serverclaude123-cmyk/scada-mojokerto/README.md

# SCADA 2 VSD ABB – Mojokerto

Target: ABB ACS550 (untuk tes dipakai ACS310). PLC-nya Schneider M221, tapi drive-nya ABB.

```
VSD1 ─┐  Modbus RTU (RS485)              LAN 192.168.1.0/24
VSD2 ─┴──────────────── ESP32-ETH ───────────┐
         baca freq/arus                      │
         + TULIS setpoint (REFERENCE 1)      │
                                             │
PLC M221 ────────────────────────────────────┤   ON/OFF hardwired ke DI VSD
                                             │
PC ini ──────────────────────────────────────┘
  ├─ broker MQTT   ◄── ESP32 publish, FUXA subscribe
  └─ FUXA HMI      ──► Modbus TCP ke M221 (tombol START/STOP)
        ▲
        └── PC remote / HP: subscribe ke broker yang sama
```

| Fungsi | Jalur |
|---|---|
| Monitoring freq out, setpoint, arus, run/fault/comm | VSD → ESP32 (Modbus RTU) → MQTT → **broker di PC ini** → FUXA / remote |
| **Setpoint frekuensi** | MQTT → ESP32 → Modbus RTU **REFERENCE 1 (40002)** → VSD |
| Perintah ON/OFF | FUXA → **Modbus TCP ke PLC M221** → output PLC → DI VSD (hardwired) |

Pembagian kewenangan yang penting: **ESP32 boleh mengatur kecepatan, tapi tidak boleh menjalankan atau
menghentikan motor.** Yang ditulisnya hanya REFERENCE 1 (`40002`), bukan Control Word (`40001`), dan ada
pagar `#error` di `config.h` yang mencegah salah arah. Start/stop sepenuhnya milik PLC M221 lewat kontak
hardwired, dengan interlock Local/Remote dan e-stop di sisi PLC.

Gambar lengkap (arsitektur, wiring RS485 dengan nomor terminal, jalur perintah PLC): **[`docs/arsitektur-wiring.html`](docs/arsitektur-wiring.html)** — buka di browser, bisa di-print A3.
Proyek FUXA siap import: **[`fuxa/`](fuxa/)**.

## IP plan (contoh, ubah sesuai LAN)
| Perangkat | IP |
|---|---|
| Router | 192.168.1.1 |
| PC ini — broker MQTT + FUXA | 192.168.1.10 |
| PLC M221 | 192.168.1.113 (terbaca di lapangan; rencana awal .20) |
| ESP32 | 192.168.1.11 (DHCP; `config.h` masih menyetel statis .50 — belum dipakai board) |

## 1. Firmware ESP32
Board: KhursLabs ESP32-S3 IoT Acquisition RS485-Ethernet (W5500: CS 5, MOSI 11, SCK 12, MISO 13, RST 21, INT 47; RS485 UART1 **TX 15 / RX 16**, auto-direction). Pin W5500 dan RS485 keduanya sesuai dokumentasi KhursLabs: W5500 dari silkscreen board, RS485 dari contoh resmi `Test_sht20_RS485.ino`. Folder: `firmware/` (PlatformIO, platform pioarduino / arduino-esp32 3.x). Ubah dulu:
1. `include/secrets.h` → host/user/password broker MQTT.
2. `include/config.h` → IP, baud (`MB_BAUD` harus sama dengan par 5303 drive), slave ID VSD, alamat register.
   Terminal sekrup "SERIAL 1" (17/18) **bukan** jalur RS485 — itu breakout UART TTL terpisah.

```bash
cd firmware
pio run -t upload
pio device monitor
```

### VSD ABB ACS550 – Modbus RTU on-board (EFB)
Tidak perlu modul fieldbus tambahan. Wiring di terminal X1:
```
ESP32 modul RS485        ACS550 #1 (X1)      ACS550 #2 (X1)
 A (-) ───────────────── 30 (A, negatif) ─── 30 (A)
 B (+) ───────────────── 29 (B, positif) ─── 29 (B)   (label modul bisa terbalik; tukar bila tak komunikasi)
 GND  ────────────────── 31 (AGND) ───────── 31 (AGND)
 shield ──────────────── 28 / 32 (SCR) — ground shield di satu ujung saja
```
- Kabel twisted pair berselubung. Terminasi 120 Ω di ujung bus (ACS550 punya switch terminasi di board kontrol – cek manual; satu lagi di modul RS485).
- Parameter di tiap drive:

| Param | Nilai |
|---|---|
| 9802 COMM PROT SEL | 1 (STD MODBUS) |
| 5302 EFB STATION ID | **1** (VSD1), **2** (VSD2) |
| 5303 EFB BAUD RATE | **19.2 kbps** — dikonfirmasi di lapangan; harus sama dengan `MB_BAUD` di `config.h` |
| 5304 EFB PARITY | 0 = 8 NONE 1 (default pabrik 1 = 8N2, harus diubah) |
| 5305 EFB CTRL PROFILE | **0** = ABB DRV LIM (profil ABB Drives; 1 = DCU, jangan dipakai) |
| 1001 EXT1 COMMANDS | **9** — terbaca di drive terpasang (10 Nov 2026). Sumber **start/stop**, dari digital input yaitu PLC. **9 bukan COMM**: manual ACS550 menyebut COMM = **10** (lihat deskripsi fault 1007). Jangan diubah ke 10, start/stop memang bukan lewat Modbus. |
| 1103 REF1 SELECT | **8 = COMM** — sumber **referensi frekuensi**, dari Modbus (ESP32). Wajib 8 supaya tulis setpoint ke 40002 dipakai drive. |
| 1105 REF1 MAX | **50,0 Hz** — harus sama dengan `REF1_MAX_HZ` di `config.h`, lihat bagian setpoint. |

- Setelah ganti 9802, power-cycle / tunggu EFB restart. Cek par 5306–5309 (EFB OK/ERR frames) naik saat polling jalan.
- **1001 dan 1103 mengatur dua hal yang BERBEDA dan berdiri sendiri.** 1001 = sumber start/stop
  (di sini 9 = digital input dari PLC); 1103 = sumber referensi frekuensi (di sini 8 = COMM lewat
  Modbus). Jadi wajar start/stop lewat PLC sementara setpoint lewat ESP32 -- keduanya tidak saling
  meniadakan. Dulu bagian ini tertulis "Modbus hanya dibaca"; itu sudah tidak berlaku sejak tulis
  setpoint diaktifkan.
- Kalau benar 9 = `DI1F,2R` (sumber sekunder, **belum dikonfirmasi dari manual ABB**), maka
  **DI2 berarti perintah jalan MUNDUR**. Pastikan tidak ada kabel PLC yang tersambung ke DI2
  tanpa sengaja sebelum motor disambung.

Register yang dibaca (`config.h`). Alamat PDU = nomor register − 40001:

| Isi | Register | Alamat PDU | Skala |
|---|---|---|---|
| Status Word | `40004` | 3 | bit |
| par 0103 OUTPUT FREQ | `40103` | 102 | 0,1 Hz |
| par 0104 CURRENT | `40104` | 103 | 0,1 A |
| par 0107 DC BUS VOLTAGE | `40107` | 106 | 1 V |
| par 0109 OUTPUT VOLTAGE | `40109` | 108 | 1 V |
| par 0111 EXT REF 1 | `40111` | 110 | 0,1 Hz |

Bit status: `RDY_REF` = run, `TRIPPED` = fault.

Par 0103–0111 diambil dalam **satu** FC03 (alamat 102, 9 register) supaya lalu lintas RS485 turun dari 6 transaksi jadi 2 per VSD per siklus. Kalau drive menolak rentang itu (exception 02), firmware otomatis kembali membaca satu-satu dan mencatatnya di serial monitor — matikan permanen dengan `MB_BLOCK_READ 0`.

### Tulis setpoint frekuensi (AKTIF)
`ALLOW_SETPOINT_WRITE 1` di `config.h`. ESP32 menulis **REFERENCE 1** (`40002`, alamat PDU 1, FC06) dari topik MQTT `scada/mojokerto/vsd1/cmd/freq_set` (dan `vsd2/...`). Isi `0` kalau mau sementara mengembalikan firmware ke murni read-only.

- Yang ditulis hanya nilai referensi, **bukan Control Word** (`40001`) — jadi ESP32 tetap tidak bisa start/stop motor. Ada pagar `#error` di `config.h` kalau `REG_REF1` sampai diisi 0.
- Prasyarat di drive: par **1103 REF1 SELECT = 8 (COMM)** dan panel pada mode **REM**. Tanpa itu nilainya ditulis tapi diabaikan drive.
- Skala: `20000` = par **1105 REF1 MAX**. **`REF1_MAX_HZ` di `config.h` harus sama dengan
  nilai par 1105 di drive.** Kalau berbeda, kecepatan bergeser diam-diam tanpa error apa pun --
  pernah terjadi di sini: 1105 masih 25,0 Hz sementara config 50,0, sehingga permintaan 25 Hz
  diterima drive sebagai 12,5 Hz dengan `cmd_ok` tetap 1. Isi `REF1_MAX_HZ` sesuai nilai 1105 di drive (resolusi 0,1 Hz: 500 = 50,0 Hz).
- Nilai dari MQTT di-clamp ke `REF_CLAMP_MIN_HZ`…`REF_CLAMP_MAX_HZ`.
- Publish perintah **tanpa retained** — perintah retained akan dipakai ulang tiap kali ESP32 reconnect.
- Echo: `vsd1/freq_cmd` (Hz yang benar-benar dikirim) dan `vsd1/cmd_ok` (1 = drive mengakui tulisan).

### Topik MQTT (payload angka/teks biasa, retained)
Basis: `scada/mojokerto`

| Topik | Isi |
|---|---|
| `gw/status` | `online` / `offline` (LWT) |
| `gw/ip`, `gw/uptime` | IP ESP32, uptime detik |
| `vsd1/freq_out`, `vsd2/freq_out` | frekuensi output (Hz) |
| `vsd1/freq_set`, `vsd2/freq_set` | setpoint frekuensi (Hz) |
| `vsd1/current`, `vsd2/current` | arus motor (A) |
| `vsd1/volt_dc`, `vsd2/volt_dc` | tegangan DC bus (V) |
| `vsd1/volt_out`, `vsd2/volt_out` | tegangan output (V) |
| `vsd1/running`, `vsd1/fault`, `vsd1/ready` (idem `vsd2/…`) | 0 / 1 |
| `vsd1/comm_ok`, `vsd2/comm_ok` | 1 = ESP32 berhasil baca VSD |
| `vsd1/status_word`, `vsd1/err_count` (idem `vsd2/…`) | diagnosa |
| `vsd1/cmd/freq_set`, `vsd2/cmd/freq_set` | **masuk** — setpoint Hz, hanya bila `ALLOW_SETPOINT_WRITE 1` |
| `vsd1/freq_cmd`, `vsd1/cmd_ok` (idem `vsd2/…`) | echo setpoint yang dikirim + hasilnya |

Publish tiap 2 detik dan langsung saat status run/fault/comm berubah.

### Hal yang HARUS dicek di hardware
- **Alamat register** sudah dicocokkan ke manual ACS550/ACS310 dan sebagian dibuktikan dengan Modbus Poll di ACS310 (Status Word terbaca). Tetap bandingkan nilai di serial monitor dengan panel drive (par 0103/0104/0111); kalau bergeser satu parameter, ubah offset ±1 di `config.h` (masalah 0-based vs 1-based).
- Dekode status memakai profil ABB Drives (par 5305 = 0). Kalau profil DCU (5305 = 1), bit-nya berbeda.
- **Rentang blok baca** 102..110: kalau drive menolak (exception 02), serial monitor mencetak `[MB] … ditolak, pakai baca satu-satu` dan firmware lanjut jalan — bukan kegagalan fatal.
- `freq_set` = par 0111 EXT REF 1. Kalau setpoint di sistem Anda lewat EXT REF 2 (%) atau panel, sesuaikan.
- TLS: broker lokal dipakai tanpa TLS (`MQTT_USE_TLS 0`, port 1883) — lalu lintasnya tidak keluar LAN. Kalau broker nanti diberi TLS, set `MQTT_USE_TLS 1` dan port 8883.

## 2. PLC M221 (SoMachine Basic)
1. Ethernet: **IP 192.168.1.113** (terbaca di lapangan; rencana awal .20), gateway 192.168.1.1.
   Modbus TCP server aktif di port 502, menjawab unit id berapa pun.
2. Program:

| Alamat | Nama | Arah | Keterangan |
|---|---|---|---|
| `%M0` | START_VSD1 | FUXA→PLC | **pulse**, 1 = perintah start |
| `%M1` | STOP_VSD1 | FUXA→PLC | **pulse**, 1 = perintah stop |
| `%M2` | START_VSD2 | FUXA→PLC | **pulse** |
| `%M3` | STOP_VSD2 | FUXA→PLC | **pulse** |
| `%MW10` | HEARTBEAT | FUXA→PLC | ditulis FUXA tiap 1 s |
| `%I0.0` | SEL_REMOTE | input | selector Local/Remote |
| `%I0.1` | ESTOP_OK | input | NC e-stop |
| `%I0.2` / `%I0.3` | VSD1/VSD2 fault relay | input | dari relay VSD (opsional) |
| `%Q0.0` | RUN_VSD1 | output | ke DI forward VSD1 |
| `%Q0.1` | RUN_VSD2 | output | ke DI forward VSD2 |

Perintah dari FUXA bersifat **pulse**: START dan STOP adalah bit terpisah. Tombol di FUXA
menulis `1` saat ditekan (mousedown) dan `0` saat dilepas (mouseup), jadi bit-nya naik
selama tombol ditahan lalu turun sendiri.

PLC memakai SET/RESET langsung ke output. Berikut program lengkapnya dalam **Instruction List**
(SoMachine Basic / EcoStruxure Machine Expert - Basic). Empat baris pertama adalah yang sudah ada
di `m221 plc.smbp`; sisanya yang perlu ditambahkan.

```
(* ============ 1. SET/RESET output. STOP ditaruh SESUDAH START ============ *)
(* Urutan ini penting: kalau START dan STOP sama-sama aktif dalam satu scan, *)
(* RESET yang dieksekusi belakangan akan menang -- itu yang kita mau.        *)
LD    %M0
S     %Q0.0
LD    %M1
R     %Q0.0
LD    %M2
S     %Q0.1
LD    %M3
R     %Q0.1

(* ============ 2. Bersihkan bit perintah -- INI YANG BELUM ADA ============ *)
(* Tanpa ini, satu bit yang tertinggal 1 akan di-SET/RESET ulang tiap scan   *)
(* dan tombol lawannya tidak akan pernah mempan.                            *)
LD    %M0
R     %M0
LD    %M1
R     %M1
LD    %M2
R     %M2
LD    %M3
R     %M3

(* ============ 3. Interlock: Local/Remote dan E-stop ============ *)
(* %I0.0 = 1 saat selector di REMOTE; %I0.1 = 1 saat e-stop SEHAT (kontak NC) *)
LDN   %I0.0
ORN   %I0.1
R     %Q0.0
LDN   %I0.0
ORN   %I0.1
R     %Q0.1

(* ============ 4. Interlock fault drive (kalau relay fault dikabel) ======= *)
LD    %I0.2
R     %Q0.0
LD    %I0.3
R     %Q0.1

(* ============ 5. Salin status output RUN untuk FUXA ============ *)
(* FUXA membaca %M4/%M5 sebagai coil (tag plc_run_vsd1/2, address 5/6).    *)
(* Taruh PALING BAWAH supaya yang tersalin adalah hasil akhir scan.         *)
LD    %Q0.0
ST    %M4
LD    %Q0.1
ST    %M5
```

Blok 3 dan 4 harus berada **di bawah** blok 1, supaya interlock selalu menang atas perintah START.

### Cara menambahkannya di EcoStruxure Machine Expert - Basic
Proyek `m221 plc.smbp` saat ini berisi **1 POU dengan 4 rung** (8 instruksi di atas).
Yang perlu ditambahkan adalah rung ke-5 dan seterusnya, **di bawah rung 4**.

Kalau lebih nyaman menggambar daripada mengetik IL, tiap rung baru isinya sederhana —
satu kontak dan satu coil Reset:

| Rung | Kontak | Coil |
|---|---|---|
| 5 | `%M0` normally open | **Reset** `%M0` |
| 6 | `%M1` normally open | **Reset** `%M1` |
| 7 | `%M2` normally open | **Reset** `%M2` |
| 8 | `%M3` normally open | **Reset** `%M3` |
| 9 | `%I0.0` normally **closed**, diparalel dengan `%I0.1` normally **closed** | **Reset** `%Q0.0` |
| 10 | sama seperti rung 9 | **Reset** `%Q0.1` |
| 11 | `%I0.2` normally open | **Reset** `%Q0.0` |
| 12 | `%I0.3` normally open | **Reset** `%Q0.1` |
| 13 | `%Q0.0` normally open | coil biasa `%M4` |
| 14 | `%Q0.1` normally open | coil biasa `%M5` |

Rung 5–8 membersihkan bit perintah. Rung 9–12 interlock, dan harus berada di bawah rung 1–4
supaya selalu menang atas perintah START.

Catatan soal rung 9 dan 10: kontaknya **normally closed** dan **diparalel**, karena artinya
"selector TIDAK di Remote **atau** e-stop TIDAK sehat". `%I0.0` = 1 saat selector di REMOTE,
`%I0.1` = 1 saat e-stop sehat (kontak NC tertutup).

Rung 11 dan 12 hanya dipasang kalau relay fault drive memang dikabel ke input itu.

### Membersihkan bit yang sudah terlanjur nyangkut
Sebelum program baru di-download, cek dulu kondisi sekarang lewat animation table
SoMachine Basic: `%M0`–`%M3` harus semuanya 0. Per 1 Nov 2026 pembacaan Modbus menunjukkan
`%M1` dan `%M2` masih **1** — sisa percobaan tombol sebelum blok 2 ada. Paksa keduanya ke 0,
atau cukup download program baru lalu power-cycle PLC.

### Watchdog komunikasi (nanti, jangan dulu)
Rencananya: FUXA menaikkan `%MW10` tiap 1 detik; kalau nilainya diam 5 detik, PLC me-reset
`%Q0.0`/`%Q0.1` supaya motor berhenti saat PC atau jaringan putus.

Implementasinya butuh timer `%TM0` (TON, 5 s) dan satu word salinan untuk mendeteksi perubahan:
bandingkan `%MW10` dengan `%MW11`, reset timer kalau berbeda, lalu simpan `%MW11 := %MW10`.
**Buat ini di editor ladder, bukan disalin sebagai IL** — sintaks blok timer berbeda antar versi
SoMachine Basic dan mudah salah kalau ditulis buta.

> **Jangan aktifkan watchdog sebelum heartbeat-nya jalan.** FUXA tidak menulis `%MW10` dengan
> sendirinya — tag-nya sudah ada di proyek, tapi nilainya harus dinaikkan oleh *script* FUXA
> (Scripts → jadwal 1 detik, `$setTag('plc_heartbeat', ($getTag('plc_heartbeat') + 1) % 32767)`).
> Kalau watchdog dinyalakan di PLC tapi script-nya belum ada, motor tidak akan pernah bisa run.

Mode Local (selector) tetap mengutamakan operator di panel.

> **Jangan aktifkan watchdog sebelum heartbeat-nya jalan.** FUXA tidak menulis `%MW10` dengan
> sendirinya — tag-nya ada, tapi nilainya harus dinaikkan oleh *script* FUXA (Scripts → jadwal 1 s,
> `$setTag('plc_heartbeat', ($getTag('plc_heartbeat') + 1) % 32767)`). Kalau watchdog dinyalakan di PLC
> tapi script-nya belum ada, motor tidak akan pernah bisa run.

## 3. Broker MQTT (di PC ini)

Broker adalah simpul tengah arsitektur ini: ESP32 publish ke sini, FUXA dan klien remote subscribe dari sini.
**Belum terpasang** — per 1 Nov 2026 tidak ada yang listen di 1883/8883 di PC ini dan Mosquitto belum ada.

Pilihan paling sederhana: **Eclipse Mosquitto**. Yang perlu ada di `mosquitto.conf`:

```
listener 1883 0.0.0.0
allow_anonymous false
password_file C:\Program Files\mosquitto\passwd
```

- `listener 1883 0.0.0.0` — tanpa ini Mosquitto hanya mendengar di localhost dan **ESP32 tidak akan bisa masuk**.
- Buat user dengan `mosquitto_passwd -c passwd esp32`, lalu isi user/password yang sama di `firmware/include/secrets.h`.
- Buka port 1883 di Windows Firewall untuk jaringan privat.
- `MQTT_HOST` di `secrets.h` diisi **IP LAN PC ini** (`192.168.1.10`), bukan `localhost`.

PC ini harus tetap menyala: kalau broker mati, FUXA dan semua klien remote kehilangan data,
walaupun ESP32 dan PLC tetap jalan sendiri.

### Akses dari luar (PC remote / HP)
Selama semua klien ada di LAN yang sama, cukup arahkan ke `192.168.1.10:1883`.

Untuk akses dari luar jaringan, **jangan port-forward 1883 apa adanya ke internet**. Port MQTT polos
tanpa TLS berarti user dan password lewat sebagai teks biasa, dan broker yang terbuka akan discan
dalam hitungan jam — padahal topik `cmd/freq_set` di broker ini bisa mengubah kecepatan motor.
Dua jalan yang aman: VPN (WireGuard/Tailscale) sehingga HP seolah berada di LAN, atau aktifkan
TLS di Mosquitto (port 8883, sertifikat) lalu set `MQTT_USE_TLS 1` di `config.h`.

## 4. FUXA (PC lokal)
**Device 1 – MQTT (monitoring)**
- Connections → Add → *MQTT client*; URL `mqtts://<host-broker>:8883`, isi user/password.
- Tambahkan tag dengan tipe *Subscription*, topik penuh, mis. `scada/mojokerto/vsd1/freq_out`, untuk semua topik di tabel di atas.

**Device 2 – Modbus TCP (perintah)**
- Add → *Modbus TCP*; `192.168.1.20:502`, Slave ID 1 (atau 255 untuk M221).
- Tag Coil: `%M0`–`%M3` (START1, STOP1, START2, STOP2). Tag heartbeat: Holding Register `%MW10`.
  **Catatan alamat:** FUXA memakai alamat 1-based dan mengurangi 1 sebelum mengirim ke bus,
  jadi `%M0` diisi address **1**, `%M1` → **2**, `%M2` → **3**, `%M3` → **4**, `%MW10` → **11**.
- Tombol START/STOP memakai aksi *set value* = `1` ke coil masing-masing (pulse).
- Beri konfirmasi (dialog) pada tombol START/STOP di FUXA.
- Semua tag di atas sudah jadi di `fuxa/scada-mojokerto.fuxap` — tinggal import, lihat `fuxa/README.md`.

**Layar**: 2 panel (VSD1/VSD2) berisi lampu RUN/FAULT/COMM, nilai Hz out, Hz set, Arus, tombol START/STOP, indikator `gw/status`. Alarm: `fault=1`, `comm_ok=0`, `gw/status=offline`.

Menu/nama field FUXA bisa sedikit berbeda antar versi.

## Status
Firmware **sudah dikompilasi bersih** (arduino-esp32 3.3.12 — RAM 9.7%, Flash 56.7%, tanpa warning),
tapi **belum pernah dijalankan di hardware**: W5500, RS485 TX15/RX16, MQTT, dan blok baca 102..110
semuanya masih belum terbukti.

Proyek FUXA sudah jadi dan sudah diuji import ke FUXA 1.3.5 — lihat `fuxa/README.md`.
Program PLC M221 belum dibuat; ladder contohnya ada di bagian 2 di atas.
