serverclaude123-cmyk/scada-mojokerto/fuxa/README.md

# Proyek FUXA – SCADA Mojokerto

`scada-mojokerto.fuxap` = file proyek FUXA siap import. Dibuat oleh `make_project.py`
(jalankan `python fuxa/make_project.py` kalau daftar tag berubah; jangan edit `.fuxap` manual).

## Isi

| Bagian | Jumlah | Keterangan |
|---|---|---|
| Device `MQTT Broker` | 31 tag | monitoring, subscribe ke `scada/mojokerto/#` |
| Device `PLC M221` | 5 tag | Modbus TCP, 4 bit perintah pulse + heartbeat |
| View `Overview` | 28 gauge | 2 panel VSD: lampu RUN/FAULT/COMM, 5 nilai, tombol START/STOP |
| Alarm | 4 | fault & comm-lost per VSD |

## Menjalankan FUXA
Tidak ada installer Windows di halaman rilis FUXA — distribusinya lewat npm atau Docker.
Butuh Node.js (diuji dengan **Node 22 LTS**; Node 26 dihindari karena modul native FUXA
belum tentu punya prebuild).

```bash
npm install -g @frangoteam/fuxa
fuxa
```

Lalu buka **http://localhost:1881**.

> Jalankan `fuxa` dari shell yang PATH-nya memuat `npm`. FUXA memanggil `npm` saat memasang
> plugin; kalau tidak ketemu, pemasangan plugin gagal dengan `'npm.cmd' is not recognized`.

## Plugin Modbus harus dipasang dulu
Paket npm FUXA **tidak** menyertakan driver Modbus. Tanpa itu, log hanya menulis
`try to create PLC M221 but plugin is missing!` dan device PLC diam saja.

Pasang lewat **Settings → Plugins → `modbus-serial`** (versi yang dipakai di sini: 8.0.19).
Driver MQTT sudah bawaan, tidak perlu plugin.

## Cara import
1. Buka FUXA → menu **☰ → Open/Save project** → **Load project** → pilih `scada-mojokerto.fuxap`.
2. **Edit kredensial broker** (tidak disimpan di Git): Connections → `MQTT Broker` →
   isi `GANTI-USER` / `GANTI-PASSWORD` sesuai user yang dibuat di Mosquitto.
   URL-nya sudah `mqtt://localhost:1883` karena broker ada di PC yang sama dengan FUXA.
   (ESP32 tidak boleh pakai `localhost` — di `secrets.h` isi IP LAN PC ini.)
3. Cek `PLC M221`: alamat `192.168.1.113:502`, Slave ID `1`. Kalau M221 tidak menjawab,
   coba Slave ID `255`.

## Pemetaan alamat Modbus ke PLC — PERHATIAN
FUXA memakai alamat **1-based** lalu mengurangi 1 sebelum mengirim ke bus
(`server/runtime/devices/modbus/index.js`: `parseInt(address) - 1`). Jadi:

| PLC M221 | Tag FUXA | Area Modbus | `memaddress` | `address` di FUXA |
|---|---|---|---|---|
| `%M0` START VSD1 | `plc_start_vsd1` | coil | `0` | **1** |
| `%M1` STOP VSD1 | `plc_stop_vsd1` | coil | `0` | **2** |
| `%M2` START VSD2 | `plc_start_vsd2` | coil | `0` | **3** |
| `%M3` STOP VSD2 | `plc_stop_vsd2` | coil | `0` | **4** |
| `%MW10` heartbeat | `plc_heartbeat` | holding register | `400000` | **11** |

Kalau tombol tampak menulis ke bit yang salah (geser satu), inilah tempat memeriksanya.

**`memaddress` harus 6 digit.** Driver Modbus FUXA membangun kunci area lewat `getMemoryAddress()`
yang mengembalikan `'000000'` untuk coil. Kalau tag diisi `'0'`, kunci tidak cocok dan tag gagal
dimuat dengan `'PLC M221' load error! TypeError: Cannot read properties of undefined (reading 'Items')`
— device tetap "created" jadi kesalahannya mudah terlewat. Pakai `000000` / `100000` / `300000` / `400000`.

## Tombol momentary (pulse 1 → 0)
Tiap tombol punya **dua** event: `mousedown` menulis `1`, `mouseup` menulis `0`.
Jadi bit perintah naik selama tombol ditahan lalu turun sendiri saat dilepas.

```json
"events": [
 {"type": "mousedown", "action": "onSetValue", "actparam": "1", "actoptions": {"variablesMapping": []}},
 {"type": "mouseup",   "action": "onSetValue", "actparam": "0", "actoptions": {"variablesMapping": []}}
]
```

**Nama event harus persis seperti itu.** FUXA 1.3.5 memakai nama pendek (`mousedown`, `onSetValue`).
Bentuk `shapes.event-mousedown` / `shapes.event-onsetvalue` yang ada di `hmi.ts` branch master
adalah format versi yang **belum dirilis** — dipakai di 1.3.5, dropdown Type/Action di editor
tampil kosong dan event-nya tidak jalan sama sekali. Acuan yang benar: konfigurasi satu tombol
lewat editor FUXA lalu baca `GET /api/project`.

Mode `buttonAction` (press/release dengan `minHoldTime`) juga hanya ada di master — tidak ada
di 1.3.5, jangan dipakai sampai versinya naik.

### PLC tetap harus membersihkan bit perintah
Lebar pulse = selama operator menahan tombol. Kalau browser, PC, atau jaringan mati di antara
mousedown dan mouseup, bitnya tertinggal `1`. Dengan pola SET/RESET di PLC, `%M0` yang terus `1`
akan me-SET ulang `%Q0.0` tiap scan dan **STOP tidak akan pernah bisa mematikan motor**.
Karena itu program PLC wajib punya `RESET %M0..%M3` setelah memprosesnya — lihat `../README.md`.

## Heartbeat `%MW10` belum otomatis
Tag `plc_heartbeat` sudah ada, tapi **tidak ada script yang menaikkannya** di proyek ini.
Kalau watchdog di PLC diaktifkan tanpa script ini, motor tidak akan pernah bisa run.
Buat di FUXA: Scripts → script baru, jadwal tiap 1 detik:

```js
$setTag('plc_heartbeat', ($getTag('plc_heartbeat') + 1) % 32767);
```

Nama fungsi script bisa berbeda antar versi FUXA — cek daftar fungsi di editor script.

## Status verifikasi
Sudah di-import ke **FUXA 1.3.5** (Node 22.23.4) dan diperiksa:

- Kedua device dimuat tanpa error (`'MQTT Broker' created/start`, `'PLC M221' created/start`).
- View ter-render: 2 panel, lampu RUN/FAULT/COMM, 5 nilai per VSD dengan placeholder `##.#`,
  tombol START/STOP berlabel, blok diagnosa.
- Alarm dan semua tag masuk.
- Di PC lapangan (1 Nov 2026) keduanya tersambung: `'MQTT Broker' start` ke
  `mqtt://localhost:1883` dan `'PLC M221' connected!` ke `192.168.1.113:502`.
  Nilai live masuk: `gw/status online`, `vsd2/comm_ok 1`, `vsd2/volt_dc 279`.
  `vsd1/comm_ok 0` dengan `err_count` terus naik itu wajar — VSD1 belum dipasang.
- Delapan `'PLC M221' _readMemory error!` di awal start adalah gejolak koneksi pertama
  (`ERR_STREAM_WRITE_AFTER_END` di `tcpport.js`), bukan tanda PLC bermasalah. Setelah
  `connected!` log bersih. Jangan buang waktu mengejarnya.

- Tombol momentary diuji dengan menekan 400 ms: FUXA memanggil `setValue` dua kali dan
  driver Modbus menghitung `val: 1` lalu `val: 0` untuk coil offset yang benar.

Yang **belum** diuji dan masih jadi tugas di lapangan:
- **Tulis coil ke M221 sungguhan.** Nilai live dari broker sudah terbukti, tapi menekan
  START/STOP ke PLC lapangan belum pernah dicoba. Perlu hati-hati: `%M1` dan `%M2` di PLC
  masih tersangkut ON, dan drive sekarang sudah di mode REMOTE.
- **Dialog konfirmasi START/STOP belum ada.** Tombol ini menjalankan motor lewat PLC.
  Tambahkan konfirmasi di editor FUXA (property tombol) **sebelum dipakai di lapangan**.
- Posisi/ukuran elemen: koordinat tetap 1200×800, rapikan di editor kalau perlu.

### Kotak isian setpoint
Tiap panel punya kotak isian yang terhubung ke tag publish `vsdN_cmd_freq_set`.
Ketik angka lalu tekan **Enter** untuk mengirim.

Strukturnya sama polanya dengan tombol: `<g id="HXI_...">` berisi `<rect>` dan
`<foreignObject>` dengan `<INPUT id="I-HXI_...">`. Tanpa INPUT ber-prefiks `I-` itu,
FUXA hanya menggambar kotak putih yang tidak bisa diketik.

Terbukti ujung ke ujung: isian di FUXA -> `vsd2/cmd/freq_set` -> ESP32 -> Modbus FC06
ke 40002 -> drive ACK, terlihat dari `vsd2/cmd_ok` yang berubah 0 menjadi 1.

Diuji ulang 1 Nov 2026 lewat UI sungguhan di browser: ketik `15` lalu Enter pada kotak VSD2,
broker langsung melaporkan `vsd2/freq_set 15.0`, `vsd2/freq_cmd 15.0`, `vsd2/cmd_ok 1`.
Angkanya 15.0 dan bukan 7.5 — itu bukti par 1105 (REF1 MAX) di drive benar-benar 50 Hz dan
cocok dengan `REF1_MAX_HZ` di firmware. Setelah itu dikembalikan ke 0.

### Penanda revisi di pojok kanan atas
Tiap view memuat teks kecil `rev xxxxxxxx` di sudut kanan atas. Itu hash dari isi proyek
(items, svgcontent, daftar tag, nama alarm) yang dihitung `make_project.py` sebelum stempelnya
sendiri ditambahkan, jadi nilainya stabil antar-generate dan berubah hanya kalau proyeknya
memang berubah -- sudah diuji: mengubah satu teks atau satu rentang warna mengubah hash.

Gunanya: **bandingkan angka di layar FUXA dengan keluaran skrip.**

```bash
python fuxa/make_project.py
```

Baris terakhirnya mencetak `rev`. Kalau angka itu berbeda dengan yang tampil di FUXA, yang
sedang jalan BUKAN versi repo -- apa pun yang tertulis di catatan mana pun. Tanpa penanda ini
dua kali sudah terjadi perubahan yang tampak "tidak masuk" padahal masuk ke tempat yang salah.

### JEBAKAN: `views[0]` belum tentu view yang kamu lihat
`set-view` mencocokkan berdasarkan `view.id`, jadi id yang dikirim menentukan view MANA yang
ditimpa. Proyek bisa punya lebih dari satu view, dan urutannya bukan urutan yang terlihat:
di PC ini `views[0]` ternyata `MainView` bawaan FUXA (`v_b1131044812-111273`), bukan `Overview`
(`v_scada_mojokerto`).

Versi lama `patch_live_view.py` menimpa id view repo dengan `live["hmi"]["views"][0]["id"]`.
Akibatnya isi baru masuk ke `MainView`, `Overview` asli tidak tersentuh, dan karena
`hmi.layout.start` menunjuk `Overview`, layarnya tetap menampilkan versi lama. Gejalanya
menyesatkan: perubahan tampak gagal diterapkan, padahal berhasil -- ke view yang salah -- dan
menyisakan dua view bernama sama.

Sekarang skrip mencocokkan lewat `id` dulu, baru lewat `name`, berhenti kalau ada lebih dari
satu view bernama sama, dan memperingatkan kalau `layout.start` menunjuk ke view lain.

#### Membersihkan view kembar
Dua view bernama sama membuat daftar Views di editor FUXA **tidak bisa diklik**, jadi
kembarannya tidak bisa dihapus lewat editor. Pakai:

```
fuxa\hapus-view-kembar.cmd
```

Skrip itu menampilkan dulu semua view apa adanya tanpa mengubah apa pun, baru bertanya.
Pagar pengamannya: view yang ditunjuk `hmi.layout.start` dan view yang dipakai menu navigasi
tidak pernah jadi calon, hanya view yang namanya kembar yang dipertimbangkan, view terakhir
tidak dihapus, dan id-nya harus diketik ulang untuk mengonfirmasi tiap penghapusan.

Untuk sekadar melihat tanpa login:

```bash
python fuxa/hapus_view_kembar.py --dry-run
```

### JEBAKAN: proyek yang jalan bisa menyimpang dari file `.fuxap` di repo
Proyek yang aktif disimpan FUXA di `_appdata/project.fuxap.db`, bukan dibaca dari
`scada-mojokerto.fuxap`. File `.fuxap` hanya dipakai saat import. Begitu ada yang menyunting
lewat editor FUXA, keduanya bisa berbeda tanpa ada peringatan apa pun.

Itu sudah terjadi: proyek yang jalan sempat hanya punya 26 item sedangkan file repo punya 28 —
dua `svg-ext-html_input` setpoint hilang, sementara empat tombol START/STOP tetap utuh.
Cara memeriksanya cepat, bandingkan jumlah item per tipe:

```bash
curl -s http://127.0.0.1:1881/api/project
```

**Jangan memulihkannya dengan mengimpor ulang `.fuxap`.** File di repo masih berisi
`GANTI-USER` / `GANTI-PASSWORD`, jadi mengimpornya akan menghapus kredensial broker di
proyek yang jalan dan FUXA langsung putus dari Mosquitto.

Cara yang aman adalah mengganti **view saja**, karena device sama sekali tidak disentuh:

```
POST /api/projectData   body: {"cmd": "set-view", "data": <objek view>}
```

`set-view` mencocokkan berdasarkan `view.id` (`runtime/project/index.js`, fungsi `setView`),
jadi view lama diganti di tempat, bukan ditambah sebagai view baru. Langkahnya: ambil proyek
yang jalan lewat `GET /api/project`, sisipkan item yang hilang ke `items` dan potongan `<g>`-nya
ke `svgcontent`, lalu kirim balik view itu.

Satu hal yang mudah salah: di file `.fuxap` hasil `make_project.py` semua `<g>` adalah anak
langsung `<svg>`, tapi setelah FUXA menyimpannya sendiri semua item pindah ke dalam satu grup
`<g><title>Layer 1</title>`. Potongan yang disisipkan harus masuk ke dalam grup Layer 1 itu,
bukan sebelum `</svg>`, kalau tidak item tidak akan tampil.

### Catatan bentuk tombol
Gauge `svg-ext-html_button` tidak cukup `<rect>`. FUXA mencari anak ber-id awalan `B-HXB_`
(`html-button.component.ts`, `prefixB`), jadi tiap tombol butuh `<foreignObject>` berisi
`<BUTTON id="B-<id gauge>">`. Tanpa itu tombol tampil sebagai kotak warna tanpa teks.
`make_project.py` sudah membuat struktur ini.

## Tag MQTT
Semua bertipe `raw` (payload angka/teks biasa, bukan JSON), `address` = topik penuh.

- `gw_status`, `gw_ip`, `gw_uptime`
- per VSD (`vsd1_`, `vsd2_`): `freq_out`, `freq_set`, `current`, `volt_dc`, `volt_out`,
  `freq_cmd`, `running`, `fault`, `ready`, `comm_ok`, `cmd_ok`, `status_word`, `err_count`
- `vsd1_cmd_freq_set`, `vsd2_cmd_freq_set` — **publish**, retained = false.
  Hanya berguna bila firmware dibangun dengan `ALLOW_SETPOINT_WRITE 1`.

## Alarm
| Nama | Tag | Level | Kondisi |
|---|---|---|---|
| `AL_VSD1_FAULT` / `AL_VSD2_FAULT` | `vsdN_fault` | highhigh | = 1 |
| `AL_VSD1_COMM` / `AL_VSD2_COMM` | `vsdN_comm_ok` | high | = 0 |

Alarm "gateway offline" belum dibuat: `gw_status` berisi teks (`online`/`offline`),
sedangkan alarm FUXA membandingkan angka. Praktisnya kedua alarm comm-lost sudah
menutupi kasus gateway mati.
