serverclaude123-cmyk/scada-mojokerto/docs/arsitektur-wiring.html

# SCADA Mojokerto — arsitektur komunikasi & wiring perintah

2× VSD ABB ACS550 · ESP32-S3 KhursLabs (W5500) · PLC Schneider M221 · FUXA · broker MQTT lokal di PC (1883)
