serverclaude123-cmyk/scada-mojokerto/(commit log)

2026-10-31 Initial commit: SCADA 2 VSD ABB via ESP32 (firmware, docs, handoff notes)
2026-10-31 Firmware kompilasi bersih, proyek FUXA, diagram, dan perbaikan tombol pulse
    Firmware:
    - Baca par 0103..0111 dalam satu FC03 (102, 9 register) dengan fallback
    otomatis ke pembacaan satu-satu kalau drive menolak rentangnya.
    - Jalur tulis REFERENCE 1 (40002, FC06) lewat MQTT, default MATI
    (ALLOW_SETPOINT_WRITE 0), dengan clamp dan pagar #error supaya tidak
    bisa diarahkan ke Control Word 40001.
    - Kompilasi bersih di arduino-esp32 3.3.12: RAM 9.7%, Flash 56.7%.
    Belum pernah dijalankan di hardware.
    FUXA (fuxa/):
    - Generator make_project.py + scada-mojokerto.fuxap: 2 device, 36 tag,
    4 alarm, 26 gauge. Sudah diuji import ke FUXA 1.3.5.
    - Tombol START/STOP momentary: mousedown tulis 1, mou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
    [config.h, main.cpp]
2026-10-31 Perbaiki pin RS485: TX 15 / RX 16, dari contoh resmi KhursLabs
    Konfigurasi lama memakai 17/18 karena membaca label terminal sekrup
    "SERIAL 1" di casing. Itu keliru: "SERIAL 1" adalah breakout UART TTL
    yang terpisah, bukan jalur ke transceiver RS485. Dengan 17/18 drive
    tidak akan pernah membalas.
    Contoh resmi Test_sht20_RS485.ino memastikan:
    rxPin = 16 (RX2), txPin = 15 (TX2), HardwareSerial modul(1), 9600 8N1,
    dan DE/RE tidak pernah digerakkan -> transceiver auto-direction.
    Jadi MB_BAUD 9600, MB_FORMAT SERIAL_8N1, dan RS485_DE_PIN -1 yang sudah
    ada ikut terkonfirmasi, bukan lagi tebakan.
    Catatan: komentar header di file contoh itu sendiri salah (menulis
    RX 18 / TX 19 / RTS 14) dan ber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
2026-10-31 Catat hasil pembacaan serial langsung dari board
    Dibaca lewat COM3 saat board jalan di lapangan:
    - W5500 jalan, eth=UP ip=192.168.1.11 (DHCP, bukan statis .50)
    - VSD2 menjawab Modbus RTU, err=0, Status Word 0x1030
    - par 0107 DC bus terbaca 286 V -> alamat register 106 terbukti benar
    - VSD1 tidak menjawab, err naik terus
    - MQTT ditolak broker dengan rc=5 (kredensial salah di secrets.h)
    - firmware di board sudah menyimpang dari repo (ada baris log [NET])
2026-10-31 Arsitektur baru: broker MQTT lokal + setpoint lewat ESP32
    Perubahan desain dari lapangan:
    - Broker MQTT pindah ke PC lokal (192.168.1.10, plain 1883), bukan lagi
    cloud free tier TLS 8883. Klien remote (PC/HP) subscribe ke broker ini.
    - Tulis setpoint frekuensi lewat ESP32 jadi bagian desain, bukan opsional:
    ALLOW_SETPOINT_WRITE 1. ESP32 tetap hanya menulis REFERENCE 1 (40002),
    tidak pernah Control Word (40001), jadi tidak bisa start/stop motor.
    ON/OFF tetap sepenuhnya lewat PLC M221.
    Isi perubahan:
    - config.h: port 1883, MQTT_USE_TLS 0, ALLOW_SETPOINT_WRITE 1
    - secrets.example.h: arahkan ke IP LAN PC, bukan host cloud
    - README: diagram arsitektur ditulis ulang, bagian baru "3. Broke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
    [config.h, secrets.example.h]
2026-10-31 Tambah konfigurasi broker Mosquitto
    Mosquitto 2.1.2 dipasang di C:\Users\AIOPC\Tools\mosquitto (tanpa admin,
    installer NSIS dengan /S /D= ke folder user). Installer sekalian memasang
    Windows service "mosquitto" (Automatic, LocalSystem).
    broker/mosquitto.conf:
    - listener 1883 0.0.0.0 -- tanpa ini Mosquitto 2.x hanya mendengar di
    localhost dan ESP32 tidak akan pernah bisa connect
    - allow_anonymous false + password_file (path absolut, karena service
    jalan dengan CWD yang tidak pasti)
    - persistence true supaya klien baru langsung dapat nilai retained
    broker/README.md mencatat jebakan yang sudah terbukti di sini: menjalankan
    mosquitto manual sementara service hidup menghasilkan DUA broker d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
2026-10-31 Tambah setup-admin.cmd untuk langkah yang perlu Administrator
    Satu skrip yang me-restart service mosquitto (supaya membaca config baru),
    membuka port 1883 di firewall untuk profil privat, lalu memverifikasi
    listener-nya 0.0.0.0 dan bukan 127.0.0.1.
    Skrip menolak jalan kalau tidak di-elevate, supaya tidak gagal diam-diam.
    Catatan di README: akun AIOPC sebenarnya anggota grup Administrators,
    hanya dijalankan dengan token terbatas. UAC diset ConsentPromptBehaviorAdmin=5
    sehingga elevasi cukup klik Yes, tanpa password.
2026-10-31 Perbaiki config broker dan buat setup-admin.cmd lebih tahan banting
    Dua masalah yang ketemu saat mencoba menjalankan service:
    1. Backslash di akhir persistence_location dibaca sebagai penyambung
    baris dan merusak parsing. Semua path diganti ke forward slash.
    2. log_dest file dihapus. File log yang pernah dibuat service (LocalSystem)
    ber-ACL yang menolak akun biasa -- bahkan Get-Acl pun ditolak -- sehingga
    Mosquitto gagal membuka log dan start-nya bermasalah. Biarkan default.
    Config sekarang dimuat bersih: "Config loaded", plugin builtin-security
    terdaftar untuk basic-auth, dan listen socket terbuka di port 1883.
    setup-admin.cmd sekarang juga membunuh instance manual yang mungkin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
2026-10-31 Pindahkan passwd ke folder instalasi dan buat setup-admin.cmd menulis log
    password_file sekarang menunjuk C:/Users/AIOPC/Tools/mosquitto/passwd,
    satu folder lokal biasa bersama mosquitto.exe, bukan di dalam profil user.
    Menghilangkan satu variabel saat service jalan sebagai LocalSystem.
    setup-admin.cmd sekarang menyalin passwd ke sana sendiri dan menulis
    seluruh outputnya ke broker/setup-admin.log, supaya penyebab kegagalan
    net start bisa dibaca apa adanya, bukan ditebak.
    Config terverifikasi dimuat bersih: builtin-security terdaftar untuk
    basic-auth dan listen socket terbuka di port 1883.
2026-10-31 Broker MQTT lokal terbukti jalan
    Mosquitto 2.1.2 berjalan sebagai Windows service dengan listener
    0.0.0.0:1883 saja (tidak ada lagi 127.0.0.1 dari config default) dan
    aturan firewall untuk profil privat.
    Terverifikasi:
    - anonim -> ditolak, "Connection Refused: not authorised"
    - password salah -> ditolak
    - kredensial benar lewat localhost -> sukses
    - kredensial benar lewat 192.168.1.10 -> sukses (jalur ESP32, tembus firewall)
2026-10-31 Catat kondisi board terkini dan risiko sebelum flash
    - IP ESP32 berpindah karena DHCP (.11 lalu .3); build repo memakai statis .50
    - Serial memastikan firmware terpasang masih menuju broker cloud lewat TLS
    (ssl_starttls_handshake error), jadi rc=5 itu wajar dan akan hilang
    setelah di-flash ke build sekarang
    - VSD2 tetap err=0 dengan Vdc 286-288 V; VSD1 tetap tidak menjawab
    - Tandai risiko: firmware yang jalan sekarang sudah terbukti bicara dengan
    VSD2, sementara build repo memakai TX15/RX16 dari contoh vendor. Kalau
    berbeda, flash memutus komunikasi yang sudah jalan dan sumbernya tidak
    tersimpan di mana pun. Backup flash dulu.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
2026-10-31 Backup flash board diambil; folder backup dikecualikan dari Git
    Seluruh 16 MB flash disalin sebelum board ditimpa, karena firmware yang
    terpasang sudah terbukti bicara dengan VSD2 dan sumbernya tidak ada di
    repo maupun di PC manapun yang sudah dicari.
    Folder backup-firmware/ di-gitignore. Dump flash memuat secrets.h lama
    yang ter-compile -- host dan kredensial broker HiveMQ -- sebagai teks
    biasa, dan repo ini public.
    Sekalian dicatat: chip sebenarnya punya flash 16 MB dan PSRAM 8 MB,
    sementara platformio.ini masih menyetel flash_size 4MB.
2026-10-31 Baud Modbus 19200 (terbukti di hardware) + log status jaringan
    MB_BAUD dikembalikan ke 19200. Saya sempat "mengoreksi" README dari
    19.2k ke 9600 dengan alasan default pabrik dan contoh vendor SHT20 --
    itu keliru, SHT20 sensor lain. Dengan 9600 kedua VSD diam; begitu
    diubah ke 19200, VSD2 langsung menjawab err=0 dengan DC bus 284-285 V.
    Sekaligus ini membuktikan di hardware bahwa pin TX15/RX16 dari contoh
    KhursLabs memang benar, dan blok baca 102..110 diterima drive.
    Ditambah baris log [NET] tiap 5 detik berisi eth/link/ip/mqtt/rc,
    mengambil ide dari firmware PC toko. Tanpa itu "MQTT gagal" tidak bisa
    dibedakan antara kabel LAN lepas, salah jaringan, dan broker menolak.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
    [config.h, main.cpp]
2026-10-31 Ethernet jalan: pin INT W5500 salah, pakai mode polling
    Rantai data akhirnya tersambung penuh di hardware:
    VSD -> ESP32 (Modbus RTU) -> MQTT -> broker lokal.
    Penyebab Ethernet tidak pernah bisa dipakai: INT 47 yang dibaca dari
    silkscreen ternyata salah. Dengan IRQ itu, deteksi link tetap bekerja
    (link=yes) karena dibaca lewat register SPI, tapi paket masuk tidak
    pernah diproses -- DHCP tidak dapat jawaban, IP statis terpasang tapi
    ARP tidak dibalas, MQTT selalu rc=-2. Dengan W5500_INT_PIN -1 (polling)
    DHCP langsung dapat IP dan MQTT connect.
    Terverifikasi di broker: gw/status online, vsd2/comm_ok 1,
    vsd2/volt_dc 288, vsd2/status_word 4144 (0x1030).
    W5500_SPI_MHZ diturunkan ke 8 saat menel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
    [config.h, main.cpp]
2026-10-31 IP statis 192.168.1.50 dikembalikan dan terbukti terjangkau
    Setelah pin INT diperbaiki, IP statis bekerja penuh: ETH naik di
    192.168.1.50, MQTT connect ke broker lokal, dan dari PC board menjawab
    ping dengan entri ARP 92-a9-90-f3-36-f1.
    Sebelumnya statis terlihat "terpasang" tapi tidak terjangkau; itu gejala
    dari masalah IRQ, bukan dari konfigurasi statisnya.
    Status di CLAUDE.md diperbarui: seluruh rantai VSD -> ESP32 -> MQTT ->
    broker kini terbukti di hardware.
    [config.h]
2026-10-31 Rapikan Status di CLAUDE.md sesuai hasil di hardware
    Rantai data penuh VSD -> ESP32 -> MQTT -> broker lokal ditandai terbukti,
    rc=5 ditandai selesai, dan catatan IP diperbarui: statis .50 terbukti
    terjangkau setelah pin INT diperbaiki, DHCP juga jalan.
    Tes tulis setpoint tetap terbuka: kodenya aktif dan ESP32 sudah subscribe,
    tapi drive masih LOCAL (bit9 REMOTE = 0) dan par 1103 belum di-set COMM.
2026-11-01 VSD1 belum dipasang, bukan kerusakan
    Sepanjang sesi ini [vsd1] OFF dengan error yang terus naik berulang kali
    saya tandai sebagai masalah yang perlu ditelusuri. Ternyata drive-nya
    memang belum terpasang, jadi itu perilaku yang benar untuk slave yang
    tidak ada di bus.
    Dicatat supaya tidak dikejar sebagai bug di sesi berikutnya, berikut
    opsi VSD_COUNT 1 kalau mau tampilan FUXA bersih dulu.
2026-11-01 Program PLC lengkap dalam IL, termasuk rung pembersih bit perintah
    Bagian PLC di README ditulis ulang agar cocok dengan program yang
    benar-benar ada di m221 plc.smbp (SET/RESET langsung ke output),
    bukan pola latch %M10/%M11 yang sebelumnya saya karang.
    Yang ditambahkan dan belum ada di PLC:
    - blok RESET %M0..%M3 supaya bit perintah bersih sendiri tiap scan
    - interlock Local/Remote (%I0.0) dan e-stop (%I0.1)
    - interlock fault drive (%I0.2 / %I0.3)
    dengan catatan urutan: interlock harus di bawah blok SET/RESET supaya
    selalu menang atas perintah START.
    Ditambah peringatan bahwa %M1 dan %M2 saat ini masih tersangkut 1 di
    PLC, dan harus dibersihkan sebelum VSD dipindah ke mode REM.
    Watchdog s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
2026-11-01 Tambah resep ladder untuk rung PLC yang perlu ditambahkan
    Program sekarang berisi 1 POU dengan 4 rung. Ditambahkan tabel rung 5-12
    dalam bentuk kontak + coil, supaya bisa digambar langsung di editor
    ladder tanpa menyentuh sintaks IL yang berbeda antar versi.
    Rung 5-8 membersihkan %M0..%M3. Rung 9-12 interlock Local/Remote,
    e-stop, dan fault drive, dengan catatan harus diletakkan di bawah
    rung 1-4 agar menang atas perintah START.
2026-11-01 Skrip deploy FUXA untuk PC baru di site
    setup-fuxa-pc.ps1 memasang Node portable (tanpa admin), FUXA lewat npm,
    menjalankannya, lalu memuat proyek lewat REST API POST /api/project --
    cara yang sudah terbukti dipakai berkali-kali hari ini, jadi tidak perlu
    klik import di UI. Alamat broker dan PLC diisi lewat parameter, password
    ditanyakan saat jalan dan tidak pernah masuk Git.
    deploy/README.md juga mencatat rekomendasi arsitektur: broker sebaiknya
    pindah ke PC site, satu LAN dengan ESP32 dan PLC. Hari ini terbukti
    kenapa -- PC pemegang broker berpindah Wi-Fi dan seluruh sistem langsung
    putus padahal ESP32 dan PLC sendiri sehat.
    Dicatat juga apa yang sengaja TIDAK diotomatiskan: plugin modbu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
2026-11-01 Akses dari luar lewat Tailscale, broker tetap di PC site
    Koneksi site berada di belakang double NAT (192.168.1.1 -> 192.168.0.1)
    ditambah CGNAT operator, jadi port forwarding mustahil. Arah keluar
    terbuka -- diuji dengan broker.hivemq.com:1883 dan TLS 8886 -- sehingga
    Tailscale bisa dipakai tanpa memindahkan broker ke cloud.
    setup-admin.cmd menambahkan aturan firewall kedua khusus rentang
    Tailscale 100.64.0.0/10. Tanpa itu koneksi dari HP ditolak diam-diam,
    karena adapter Tailscale dikenali Windows sebagai jaringan Public
    sementara aturan 1883 yang ada hanya berlaku untuk profil Private.
    Dibatasi ke rentang Tailscale, bukan dibuka ke Public.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
2026-11-01 User broker per perangkat, dan catatan restart setelah menambah user
    Ditambahkan user hp1, hp2, pc2 supaya tiap perangkat remote punya akun
    sendiri -- akses satu perangkat bisa dicabut tanpa mengubah yang lain.
    Password acak per user, disimpan di KREDENSIAL-LOKAL.txt (tidak di Git).
    Dua hal yang sudah diuji dan dicatat:
    - Mosquitto menyimpan daftar user di memori. User baru ditolak
    "not authorised" sampai service di-restart, walau file passwd sudah
    benar. setup-admin.cmd menyalin passwd ke folder service sekaligus
    me-restart.
    - Client ID harus unik per klien. Dua klien dengan ID sama saling
    memutus, dan gejalanya mudah disalahartikan sebagai gangguan jaringan.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
2026-11-01 Kotak isian setpoint di FUXA, dan tulis setpoint terbukti sampai drive
    FUXA sebelumnya tidak punya cara mengisi setpoint sama sekali: tag
    vsdN_cmd_freq_set sudah ada dan ESP32 sudah subscribe, tapi tidak ada
    widget yang terhubung ke sana. Ditambahkan kotak isian per panel.
    Strukturnya diambil dari proyek demo FUXA, bukan ditebak: <g id="HXI_...">
    berisi <rect> + <foreignObject> dengan <INPUT id="I-HXI_...">. Tanpa
    INPUT ber-prefiks I- itu FUXA hanya menggambar kotak yang tidak bisa
    diketik -- pola yang sama dengan jebakan tombol sebelumnya.
    Diuji ujung ke ujung dengan nilai 0 Hz (sengaja nol supaya tidak
    meninggalkan setpoint tersembunyi saat motor dinyalakan nanti):
    vsd2/cmd/freq_set 0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
2026-11-01 Skala setpoint terbukti benar setelah par 1105 diset 50 Hz
    Tes pertama 25 Hz diterima drive sebagai 12,5 Hz -- tepat setengahnya.
    Sebabnya par 1105 REF1 MAX di drive masih 25,0 Hz, sisa percobaan lama
    yang sebenarnya sudah tercatat di CLAUDE.md ("pernah 1105 tertulis 250"),
    sementara REF1_MAX_HZ di config memakai 50,0.
    Ini kelas kesalahan yang berbahaya karena diam: cmd_ok tetap 1, tidak ada
    error, motor hanya berputar separuh permintaan. Baru ketahuan karena tes
    memakai nilai bukan nol dan membandingkan dengan freq_set yang dibaca
    balik dari par 0111, bukan sekadar melihat cmd_ok.
    Setelah par 1105 diset 50,0 Hz di panel drive, 25 Hz terbaca balik 25,0.
    Setpoint dikembalikan ke 0 setelah p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
2026-11-01 Kunci folder data FUXA lewat --userDir; proyek "hilang" karena CWD
    Setelah scheduled task aktif, FUXA tampak kosong. Penyebabnya bukan data
    yang hilang: main.js menentukan folder datanya dari current working
    directory -- workDir = path.resolve(process.cwd(), '_appdata'). FUXA yang
    dulu dijalankan dengan CWD C:\ menyimpan proyek di C:\_appdata, sedangkan
    scheduled task berjalan dengan CWD C:\Windows\System32 sehingga FUXA
    membuat _appdata baru yang kosong di sana.
    Perbaikannya: task sekarang dibuat dengan --userDir "C:\ProgramData\fuxa",
    jadi lokasi data pasti dan tidak bergantung siapa yang menjalankan.
    Skrip juga memeriksa keberadaan project.fuxap.db di sana lebih dulu dan
    memperingatkan k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
2026-11-01 deploy: salin _pkg/_db/_images/_widgets saat memakai --userDir
    --userDir tidak hanya memindahkan _appdata. main.js juga menggeser rootDir,
    dan _pkg/_db/_images/_widgets di-resolve relatif ke sana. _pkg adalah tempat
    plugin terpasang (_pkg/runtime/node_modules/modbus-serial di PC ini), jadi
    tanpa ikut dipindah device PLC M221 akan gagal dimuat dengan
    "plugin is missing!" walau plugin-nya sudah terpasang.
    Langkah [3/5] baru menyalin keempat folder itu dari folder paket npm ke
    --userDir, hanya kalau belum ada, dan ditaruh setelah taskkill supaya berkas
    SQLite di _db tidak tersalin setengah tertulis. Langkah lama dinomori ulang.
    Perbaiki juga dua path di deploy/README.md yang rusak karena \f p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
2026-11-01 fuxa: catat penyimpangan proyek live dan cara pulih yang aman
    Proyek yang jalan sempat hanya punya 26 item sedangkan fuxa/scada-mojokerto.fuxap
    punya 28: dua svg-ext-html_input setpoint hilang. Penyebabnya proyek aktif hidup di
    _appdata/project.fuxap.db dan bisa menyimpang dari file .fuxap tanpa peringatan.
    Memulihkan dengan mengimpor ulang .fuxap justru merusak: file repo masih berisi
    GANTI-USER/GANTI-PASSWORD sehingga kredensial broker terhapus dan FUXA putus dari
    Mosquitto. Yang dipakai POST /api/projectData cmd set-view, yang hanya mengganti
    view dan tidak menyentuh device. Dicatat juga bahwa SVG hasil simpanan FUXA
    menaruh semua item di dalam grup Layer 1, jadi potongan sisipan harus m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
2026-11-10 deploy: task FUXA tahan Fast Startup dan tanpa batas 72 jam
    FUXA tidak bisa diakses tiap PC dinyalakan. Dua sebab yang menumpuk:
    1. Fast Startup aktif (HiberbootEnabled=1). "Shut down" meng-hibernate kernel,
    bukan mematikan: event Kernel-Boot 27 mencatat 0x1 untuk semua boot sejak
    6 Nov, dan event 6005 (Event log service started) tidak pernah muncul di
    boot-boot itu. Layanan Windows tidak di-restart, jadi pemicu "At startup"
    tidak menyala. Proses SYSTEM ikut terbawa hibernate sehingga selama FUXA
    tidak pernah mati semuanya tampak normal; begitu mati sekali, tidak ada
    yang menghidupkannya. Pada 9 Nov FUXA SYSTEM diganti proses sesi user,
    yang mati di tiap shutdown -- sej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
2026-11-10 plc+fuxa: status RUN asli dari PLC, dan lampu PLC di HMI
    Selama ini lampu RUN di FUXA memakai status dari VSD lewat MQTT. Sekarang
    output PLC ikut ditampilkan apa adanya.
    PLC (m221 plc.smbp): rung 13-14 menyalin %Q0.0 -> %M4 dan %Q0.1 -> %M5.
    %Q tidak bisa dibaca langsung lewat Modbus, jadi disalin ke memory bit.
    Ditaruh paling bawah supaya yang tersalin hasil akhir scan.
    FUXA: tag coil baru plc_run_vsd1/2 (address 5/6) plus lampu per panel, dan
    satu lampu "PLC M221" di header yang memakai plc_start_vsd1 sebagai penanda
    sambungan Modbus TCP -- nilai 0 dan 1 sama-sama hijau, hanya nilai kosong
    (device putus) yang membuatnya merah. Label "Gateway ESP32" jadi "Gateway".
    Tambah fuxa/patch_liv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
2026-11-10 docs: catat 1001 = 9 dan tegaskan 1001 vs 1103 adalah dua sumber berbeda
    Nilai 1001 EXT1 COMMANDS di drive terpasang terbaca 9, bukan 1 atau 2 seperti
    dugaan dari daftar opsi di manual. Itu benar dan tidak perlu diubah: 9 adalah
    sumber digital input (dari PLC), sedangkan COMM adalah 10 -- dikonfirmasi dari
    manual ACS550-01/U1 pada deskripsi fault 1007 PAR FIELDBUS MISSING, yang
    menyebut "1001 EXT1 COMMANDS = 10 (COMM)".
    Sumber kebingungannya: 1001 dan 1103 mengatur hal berbeda dan berdiri sendiri.
    1001 menentukan sumber start/stop, 1103 menentukan sumber referensi frekuensi.
    Karena itu start/stop bisa lewat PLC sementara setpoint lewat Modbus.
    Perbaiki juga kalimat usang "Start/stop dan re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
2026-11-10 fuxa: lampu status koneksi dari tag sistem, bukan ditebak dari nilai koil
    Lampu "PLC M221" di header selalu HIJAU walau PLC mati. Terlihat di lapangan
    10 Nov 2026: FUXA dinyalakan saat PLC belum di-ON, lampunya tetap hijau.
    Sebabnya lampu itu diikat ke koil %M0 (plc_start_vsd1) dengan rentang 0 dan 1
    sama-sama hijau. Anggapannya: kalau device putus FUXA mengosongkan nilai tag
    sehingga tidak ada rentang yang cocok dan lampu jatuh ke merah bawaan SVG.
    Anggapan itu salah -- nilainya bertahan 0, cocok rentang 0, lampu tetap hijau.
    Untuk HMI pabrik ini jenis kesalahan yang buruk: indikator yang selalu bilang
    "tersambung".
    FUXA sebenarnya sudah menyediakan yang benar. Device bawaan "Fuxa Server"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
2026-11-10 fuxa: penanda revisi di layar, dan perbaiki salah sasaran set-view
    Dua hal yang saling berkaitan, keduanya muncul dari satu kejadian: perubahan
    lampu status koneksi sudah dikirim ke FUXA tapi layar tetap menampilkan versi
    lama, dan tidak ada cara melihat itu dari layar.
    1. Salah sasaran set-view. patch_live_view.py menimpa id view repo dengan
    live["hmi"]["views"][0]["id"]. Ternyata views[0] di PC ini adalah MainView
    bawaan FUXA, bukan Overview. Isi baru masuk ke MainView, Overview asli tidak
    tersentuh, dan karena hmi.layout.start menunjuk Overview layarnya tetap versi
    lama -- tampak seperti gagal diterapkan padahal berhasil ke view yang salah,
    dan menyisakan dua view bernama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
